bigtreetech/Universal-Turbo-Kit/3D Model/readme.md

# More printer compatibility coming soon
