bigtreetech/Universal-Turbo-Kit/3D Model/Voron2.4&Trident/exhuast parts/Voron-Exhaust-UTK-SFS-without-fan/main housing.stl

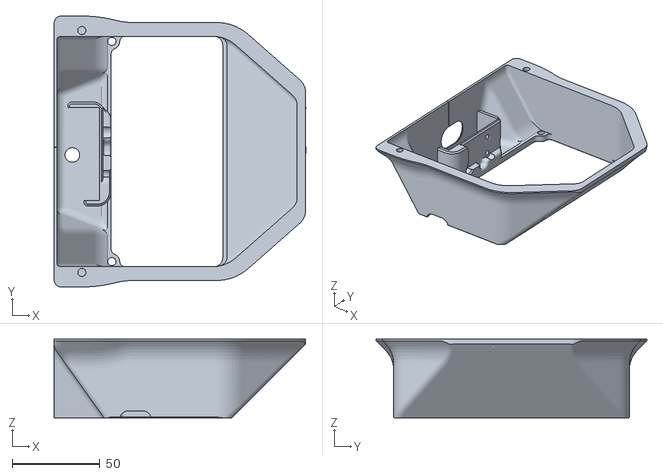
[picture p1: CAD file, 2024-05-29]
3D Model/Voron2.4&Trident/exhuast parts/Voron-Exhaust-UTK-SFS-without-fan/main housing.stl
143.8 x 154.8 x 45.0
