bigtreetech/Universal-Turbo-Kit/3D Model/Voron2.4&Trident/exhuast parts/Voron-Exhaust-UTK-SFS-with-fan/main housing with fan.stl

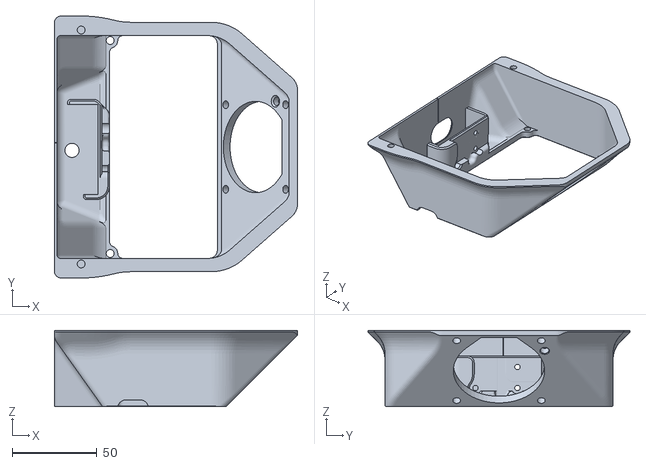
[picture p2: CAD file, 2024-05-29]
3D Model/Voron2.4&Trident/exhuast parts/Voron-Exhaust-UTK-SFS-with-fan/main housing with fan.stl
143.7 x 154.8 x 45.0
