bigtreetech/Universal-Turbo-Kit/3D Model/Voron2.4&Trident/exhuast parts/Voron-Exhaust-UTK-with-fan/blower hose adaptor.stl

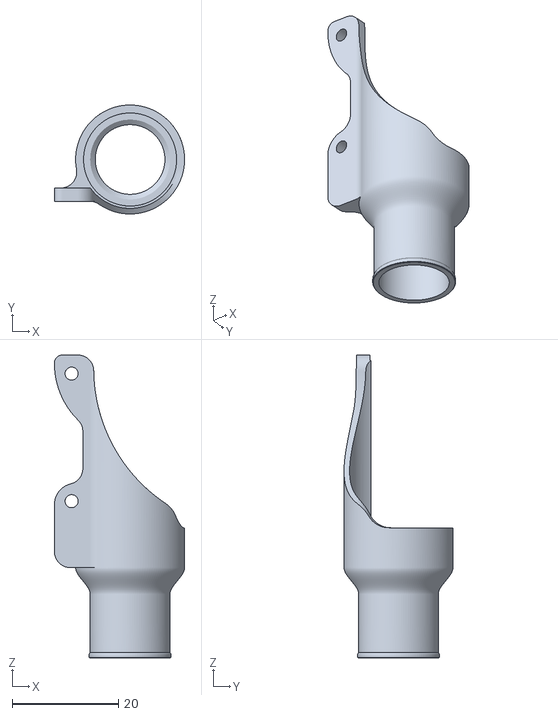
[picture p5: CAD file, 2024-05-29]
3D Model/Voron2.4&Trident/exhuast parts/Voron-Exhaust-UTK-with-fan/blower hose adaptor.stl
24.5 x 20.5 x 57.0
