bigtreetech/Universal-Turbo-Kit/3D Model/Voron2.4&Trident/exhuast parts/Voron-Exhaust-UTK-without-fan/mounting bracket.stl

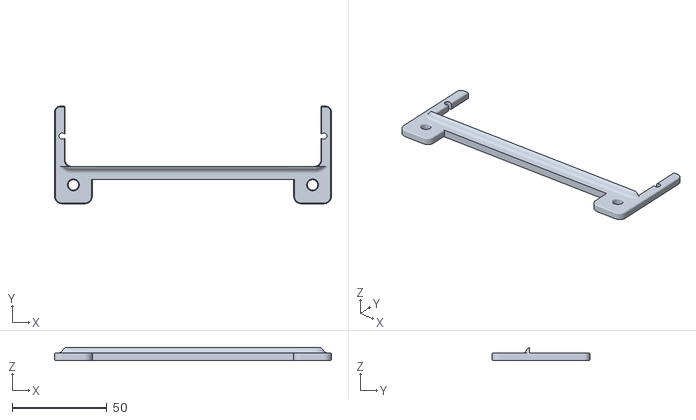
[picture p6: CAD file, 2024-05-29]
3D Model/Voron2.4&Trident/exhuast parts/Voron-Exhaust-UTK-without-fan/mounting bracket.stl
146.4 x 51.6 x 7.00
