bigtreetech/Universal-Turbo-Kit/3D Model/Voron2.4&Trident/Stealthburner Parts/knomi-cpap-no-nozzle-cam.3mf

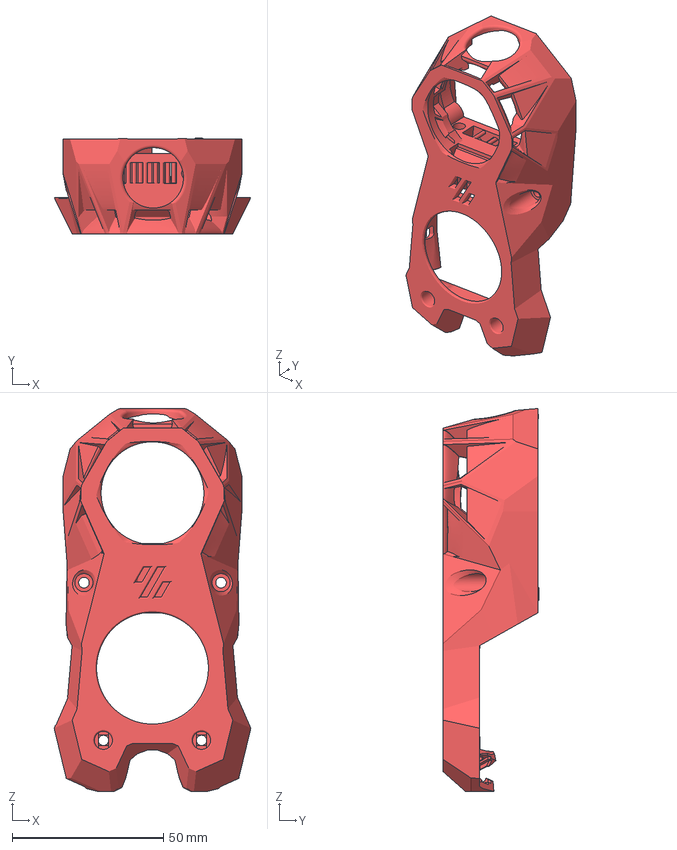
[picture p7: CAD file, 2024-07-05]
3D Model/Voron2.4&Trident/Stealthburner Parts/knomi-cpap-no-nozzle-cam.3mf
65.1 x 31.8 x 126.8 mm
