bigtreetech/Universal-Turbo-Kit/3D Model/Reference Cad Model/BLDC Driver.STEP

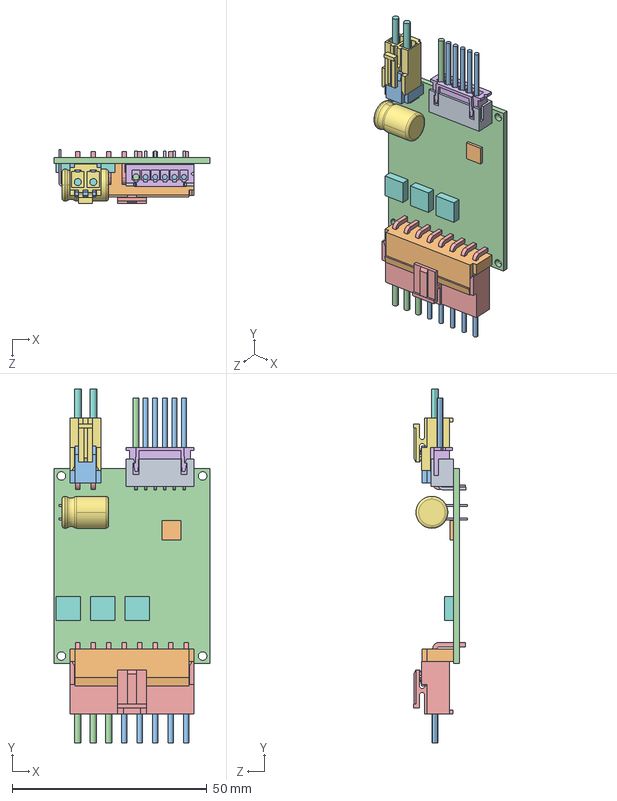
[picture p8: CAD file, 2024-06-03]
3D Model/Reference Cad Model/BLDC Driver.STEP
40.0 x 91.0 x 13.9 mm
PCB
Connector 8 pin
Connector 6 pin
Connector 2 pin
