bigtreetech/Universal-Turbo-Kit/3D Model/Voron2.4&Trident/exhuast parts/Voron-Exhaust-UTK-with-fan/4.25mm [a]_exhaust_housing_filament_insert_plug.stl

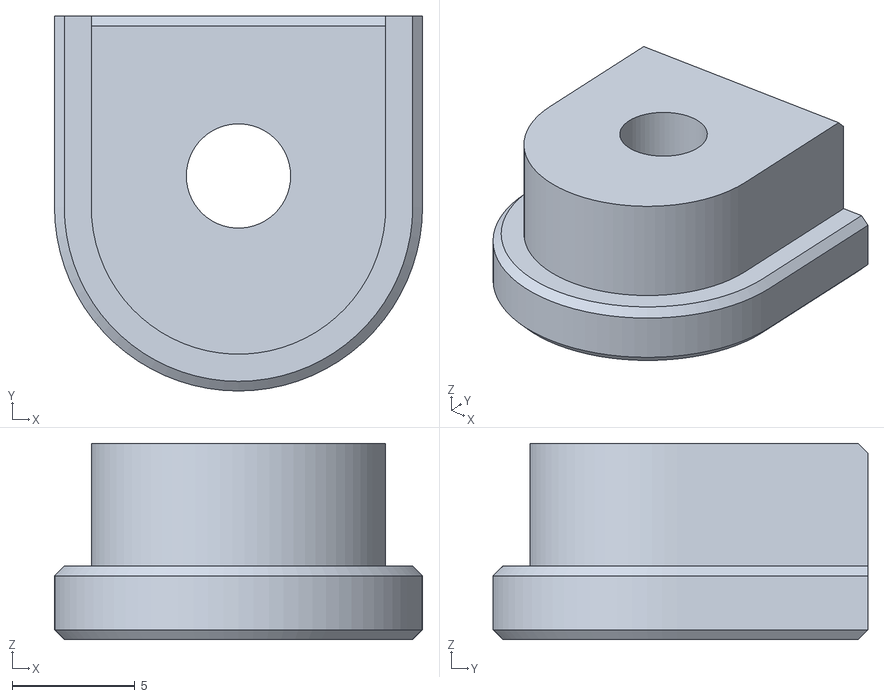
[picture p9: CAD file, 2024-05-29]
3D Model/Voron2.4&Trident/exhuast parts/Voron-Exhaust-UTK-with-fan/4.25mm [a]_exhaust_housing_filament_insert_plug.stl
15.0 x 15.3 x 8.00
