bigtreetech/Universal-Turbo-Kit/3D Model/Voron2.4&Trident/Stealthburner Parts/SB Knomi CPAP Adaptor.STEP

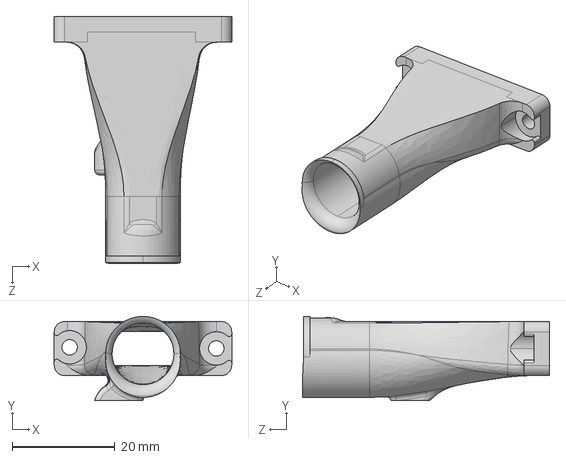
[picture p11: CAD file, 2024-05-29]
3D Model/Voron2.4&Trident/Stealthburner Parts/SB Knomi CPAP Adaptor.STEP
34.5 x 16.4 x 48.0 mm
