bigtreetech/Universal-Turbo-Kit/3D Model/Reference Cad Model/Potentiometer.STEP

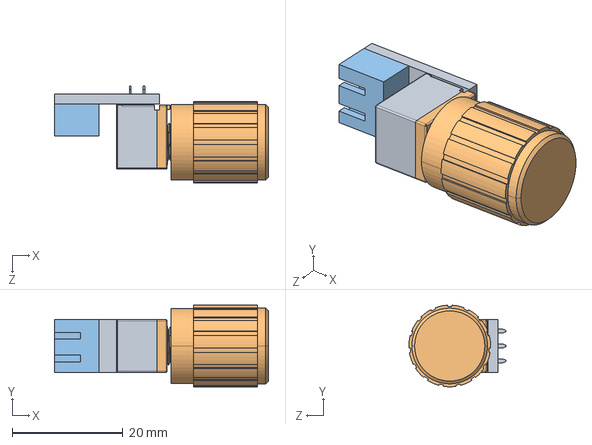
[picture p12: CAD file, 2024-06-03]
3D Model/Reference Cad Model/Potentiometer.STEP
38.7 x 14.8 x 17.6 mm
