bigtreetech/Universal-Turbo-Kit/3D Model/Voron2.4&Trident/exhuast parts/Voron-Exhaust-UTK-SFS-with-fan/ptfe collet.stl

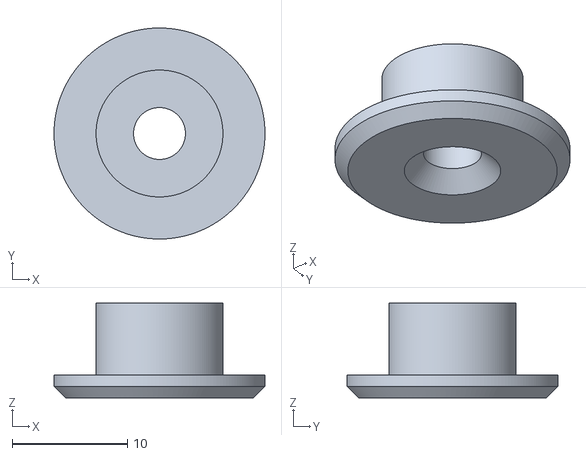
[picture p13: CAD file, 2024-05-29]
3D Model/Voron2.4&Trident/exhuast parts/Voron-Exhaust-UTK-SFS-with-fan/ptfe collet.stl
18.3 x 18.3 x 8.24
