bigtreetech/Universal-Turbo-Kit/3D Model/Voron2.4&Trident/Stealthburner Parts/Hex_mod.stl

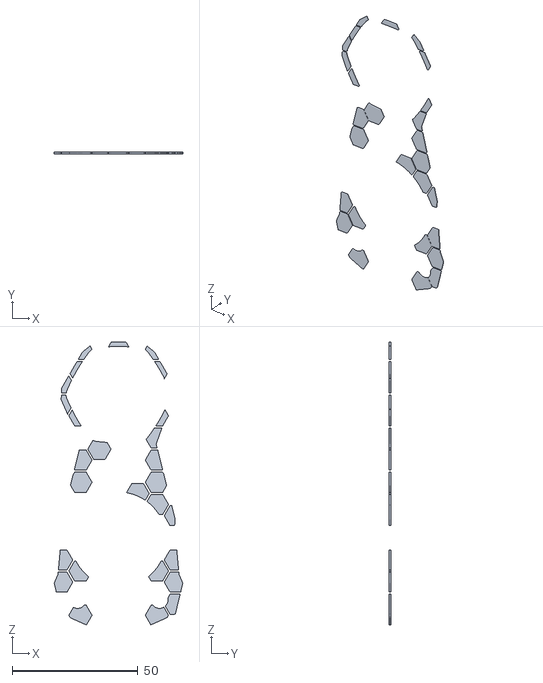
[picture p14: CAD file, 2024-05-29]
3D Model/Voron2.4&Trident/Stealthburner Parts/Hex_mod.stl
51.1 x 0.601 x 112.4
