bigtreetech/Universal-Turbo-Kit/3D Model/Voron2.4&Trident/exhuast parts/Voron-Exhaust-UTK-with-fan/cpap_wiring_insert.stl

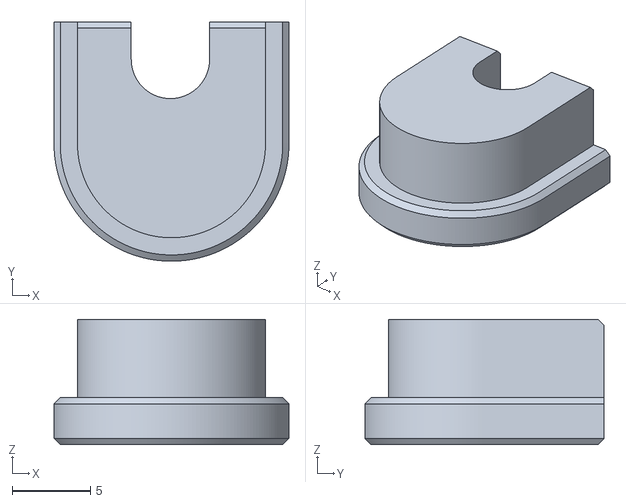
[picture p15: CAD file, 2024-05-29]
3D Model/Voron2.4&Trident/exhuast parts/Voron-Exhaust-UTK-with-fan/cpap_wiring_insert.stl
15.0 x 15.3 x 8.00
