bigtreetech/Universal-Turbo-Kit/3D Model/Voron2.4&Trident/exhuast parts/Voron-Exhaust-UTK-SFS-without-fan/grill closed.stl

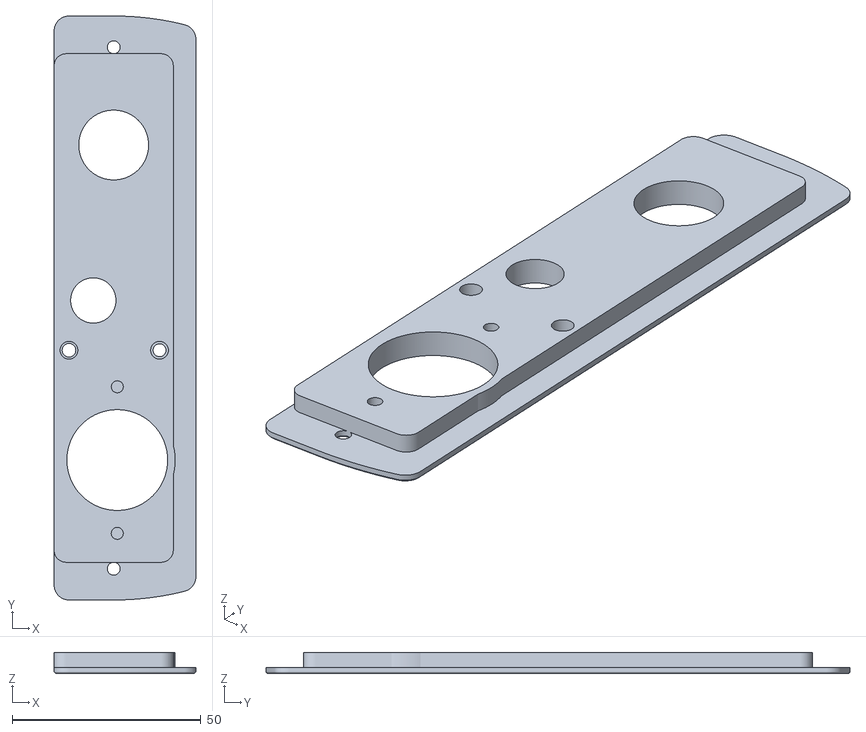
[picture p16: CAD file, 2024-05-29]
3D Model/Voron2.4&Trident/exhuast parts/Voron-Exhaust-UTK-SFS-without-fan/grill closed.stl
37.6 x 154.8 x 5.60
