bigtreetech/Universal-Turbo-Kit/3D Model/Voron2.4&Trident/exhuast parts/Voron-Exhaust-UTK-with-fan/exhaust_filter_housing v3.step.stl

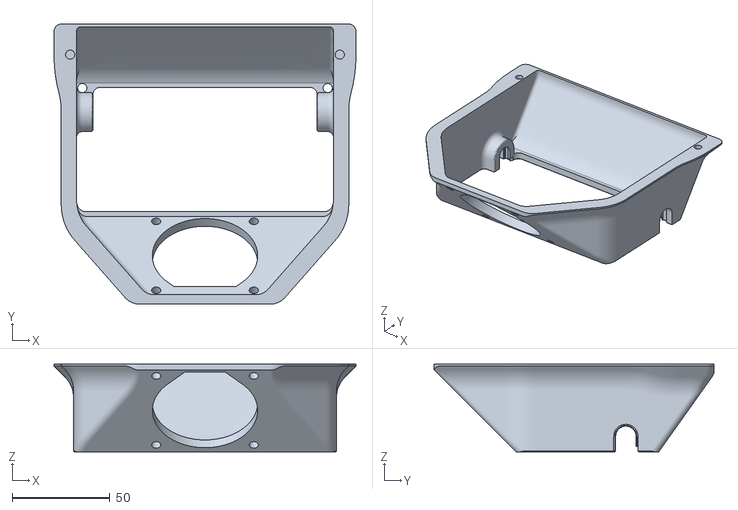
[picture p17: CAD file, 2024-05-29]
3D Model/Voron2.4&Trident/exhuast parts/Voron-Exhaust-UTK-with-fan/exhaust_filter_housing v3.step.stl
154.8 x 143.7 x 45.0
