bigtreetech/Universal-Turbo-Kit/3D Model/Voron2.4&Trident/exhuast parts/Voron-Exhaust-UTK-SFS-without-fan/filter adaptor.stl

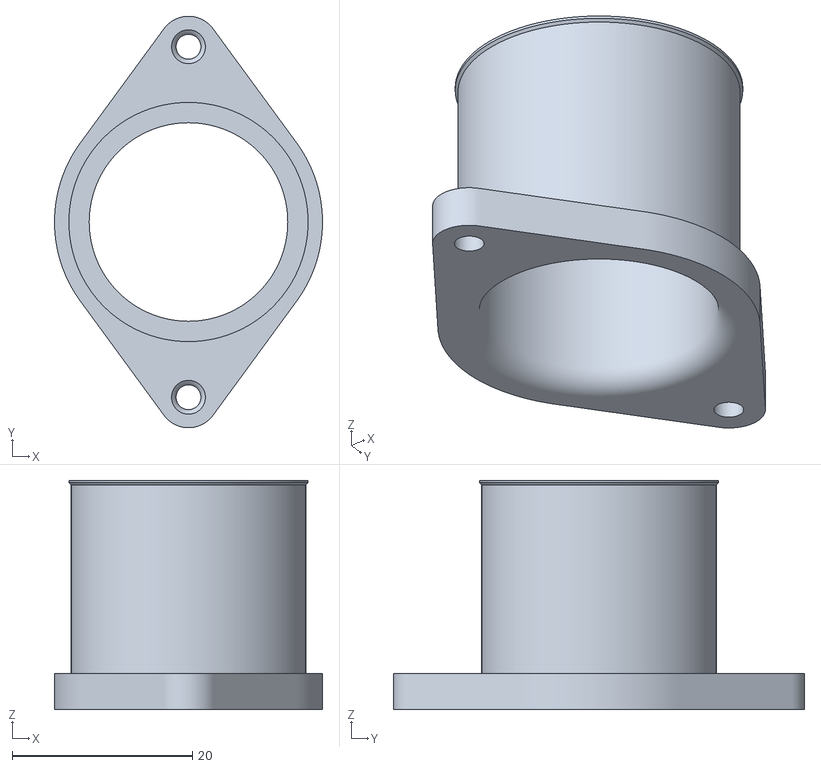
[picture p20: CAD file, 2024-05-29]
3D Model/Voron2.4&Trident/exhuast parts/Voron-Exhaust-UTK-SFS-without-fan/filter adaptor.stl
29.7 x 45.6 x 25.4
