bigtreetech/Universal-Turbo-Kit/(list of files, cad)

Other CAD files:
3D Model/Voron2.4&Trident/exhuast parts/Voron-Exhaust-UTK-without-fan/SB CPAP Adaptor.step.SLDPRT
