bigtreetech/Universal-Turbo-Kit/(threads)

Thread 1 (2024-06-02):

Stealthburner Knomi 2

Zay1Million, 2024-06-02:
The Knomi 2 does not fit in the new tool head

BTTJUSTIN, 2024-06-03:
Hi,Thanks for your reporting .
Please describe in detail which area on the printed part is causing trouble. the included print model for sb is designed for knomi v2,here is the installed assembly.  please check that your print has no imperfections.

BTTJUSTIN, 2024-06-04:
Hi，
Thanks for your reply.
1.Please send me the picture on this phenomenon"the Knomi 2 device would not fit into the slot on the stealthburner tool head."
2.And please send me the link of the  a remixed file on the printables website.
We will check on it

Zay1Million, 2024-06-05:
I already have my toolhead assembled and don't want to take it apart again to demonstrate, but the link below is the remixed file that I used. Thanks again!

https://www.printables.com/model/891528-stealthburner-cpap-knomi-2-sb2209-or-sb2240-3do-no

BTTJUSTIN, 2024-06-06:
Hi ,thanks for your sharing, it is glad to hear that you figured it out

StreckerCM, 2024-10-12:
This issue still exists with the KNOMI 2.

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

bigtreetech, 2024-10-12:
> This issue still exists with the KNOMI 2.
>

Looks as if you've printed the wrong file. That is for KNOMI 1. This will work for KNOMI 2. https://www.printables.com/model/891528-stealthburner-cpap-knomi-2-sb2209-or-sb2240-3do-no

StreckerCM, 2024-10-12:
Unfortunately there isn't a STEP file for that model and Fusion 360 wont let me modify the body it generates from the STL without giving geometry calculation errors.  The solution for those errors according to their help documents are to use the STEP file. I was trying to modify it to work with the 3DO nozzle cam V2.

Closed 2024-06-06.

Thread 2 (2024-06-10):

Stealthburner Knomi 2 -  NO nozcam

fabrimp, 2024-06-10:
Request Stealthburner Knomi 2 - NO nozecam version.

I want to use my turbo kit with Knomi 2 but do not intend to install a nozecam. The current mounting completely blocks my view of what my printer is doing.

BTTJUSTIN, 2024-06-13:
This is the link to the model that the stealthburner part is based on, you can download step file from here and modify it to your liking
https://www.printables.com/model/574324-stealthburner-knomi-can-sb22092240-cpap-nozzle-cam/files

BTTJUSTIN, 2024-07-07:
The documentation has now been updated.

Closed 2024-06-21.
