bigtreetech/Universal-Turbo-Kit/(commit log)

2024-05-29 More printer compatibility coming soon
2024-06-03 reference cad model
    [BLDC Driver.STEP, Potentiometer.STEP, WS7040-24-v200N CPAP.STEP]
2024-07-05 add knomi-cpap-no-nozzle-cam.3mf
    [knomi-cpap-no-nozzle-cam.3mf]
